cesarmiquel/a2diskarduino/(commit log)

2025-09-24 Add J8 connector pinout to readme.
2025-09-24 Fix bug when we have an external drive connected
    - The old code worked fine if you didn't have another drive connected.
    When you do, you need to only send data when you are enabled. Added
    A2_DR1 to check when we are activated.
    [apple2c-drive-v2.ino]
2025-09-24 Switch A2_WREQ and A2_WRDATA.
2025-09-24 Switch A2_DR1 <> A2_WRREQ to simplify wiring.
    - This avoids crossing wires.
    [apple2c-drive-v2.ino]
2025-09-24 Add +5V and GND connections to Arduino Nano.
2025-09-24 Fix bug with keyboard circuit.
